t4n/arduino-solar/img/IMGP2865.JPG

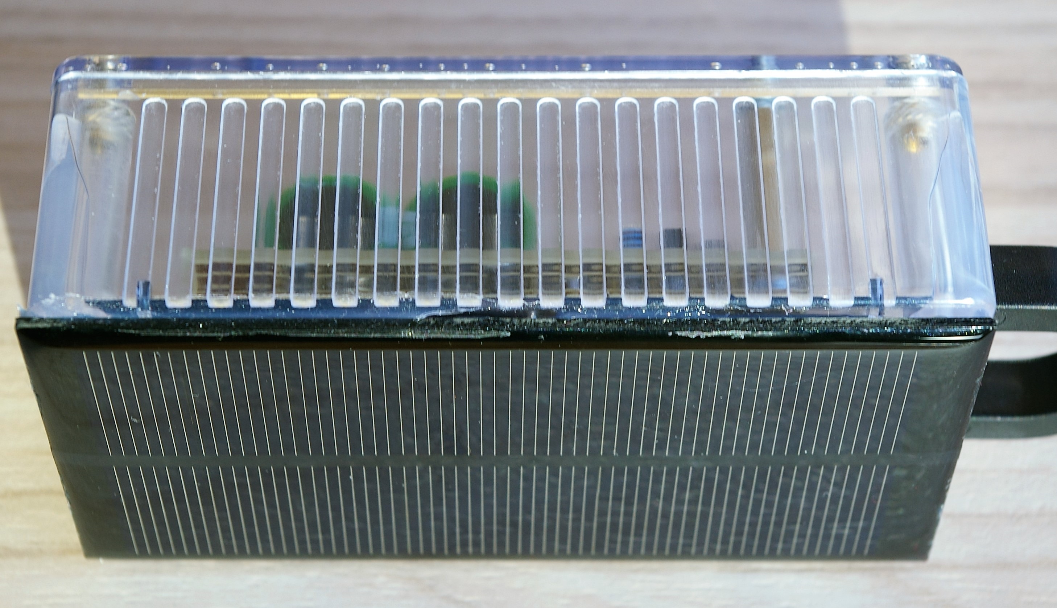
img/IMGP2865.JPG
