t4n/arduino-solar/img/IMGP2863.JPG

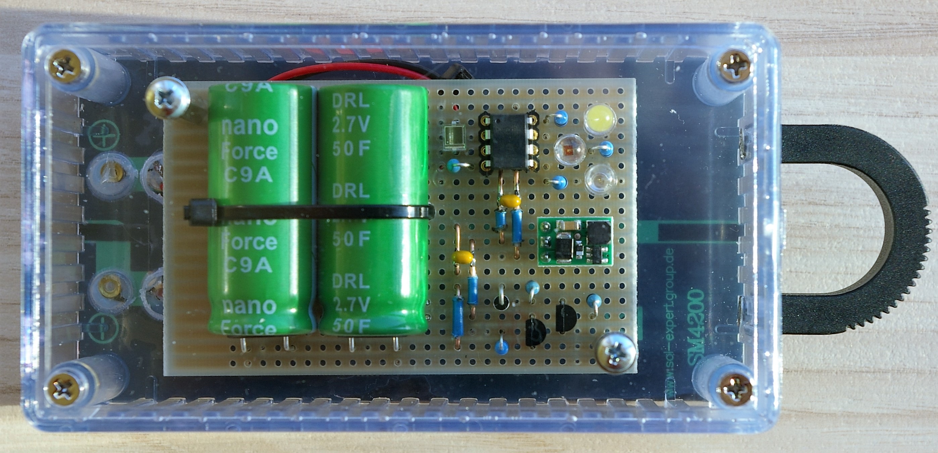
img/IMGP2863.JPG
