t4n/arduino-solar/README.md

# Arduino-kompatibles Solarlicht mit Supercaps

* arduino-solar/img:
  Fotos vom Aufbau des Solarlichts
* arduino-solar/pcb:
  Layout der Streifenrasterplatine
* arduino-solar/schem:
  Schaltung des Solarlichts
