t4n/arduino-solar/img/IMGP2876.JPG

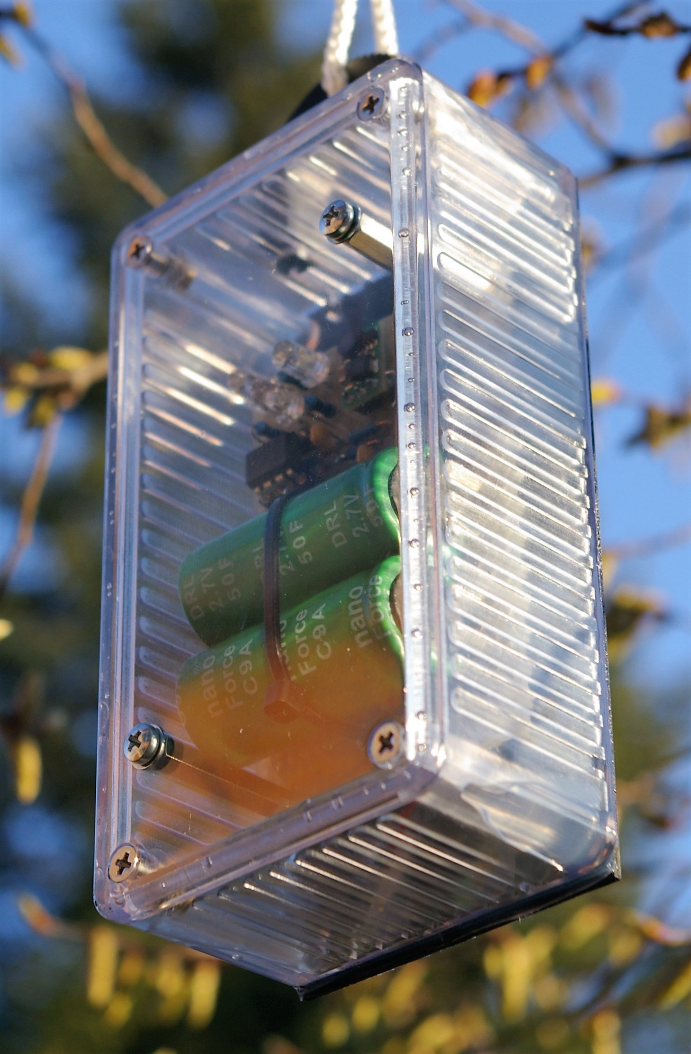
img/IMGP2876.JPG
