t4n/arduino-solar/pcb/Layout.pdf

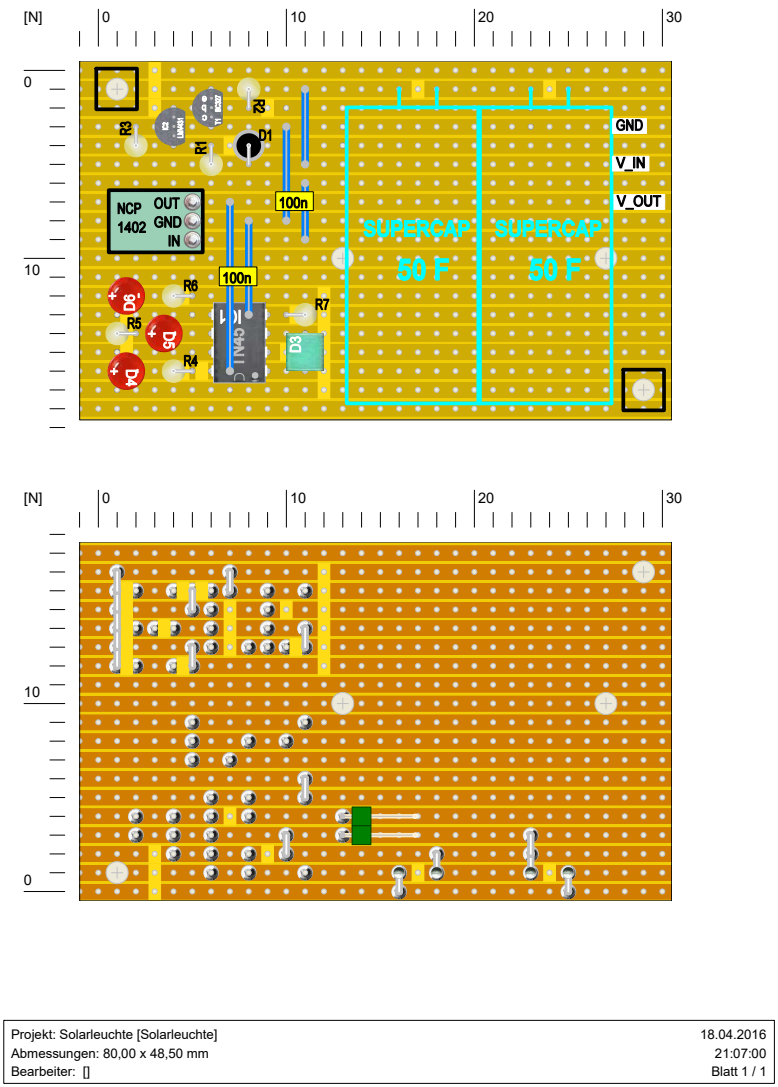
[picture p11: page 1]
18.04.2016 21:07:00 Blatt 1 / 1

Projekt: Solarleuchte [Solarleuchte]
Abmessungen: 80,00 x 48,50 mm
Bearbeiter: []
