t4n/arduino-solar/schem/Schaltung.pdf

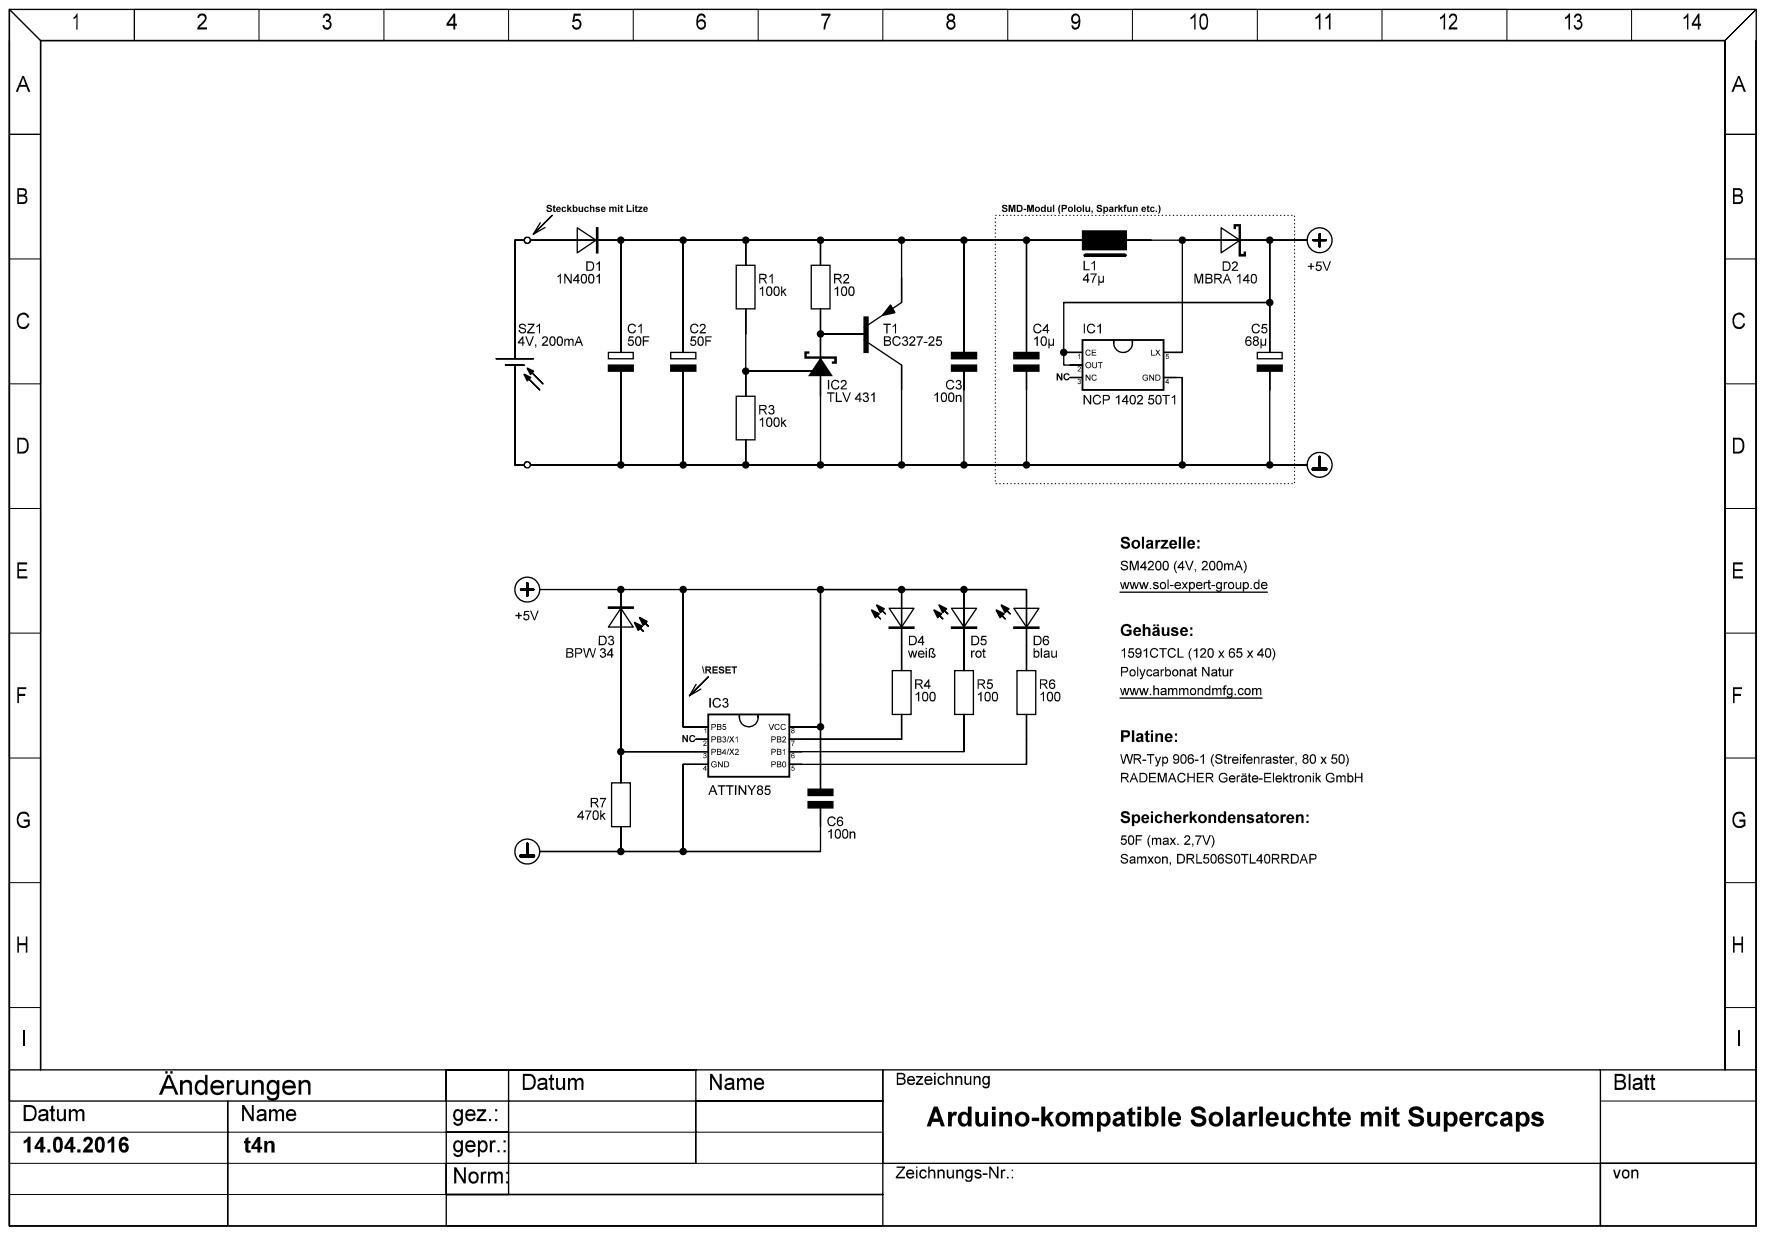
[picture p12: page 1]
