t4n/arduino-solar/(commit log)

2018-05-17 Add files via upload
    Der vorliegende Artikel „Solarzellen, Supercaps und ein kleiner Mikrocontroller“ wurde im August 2016 im Online-Magazin myembedded.de veröffentlicht
2018-05-17 Update Solarlicht.ino
    Die erste AD-Wandlung nach dem Aufwachen des Controllers wurde - auch wenn der Kommentar im Quelltext das Gegenteil behauptet hat - nicht verworfen, sondern tatsächlich in den Mittelwert der letzten vier Messungen einbezogen...
